analogicus/lelo_gr03_sky130a/svgs/LELO_GR03.png

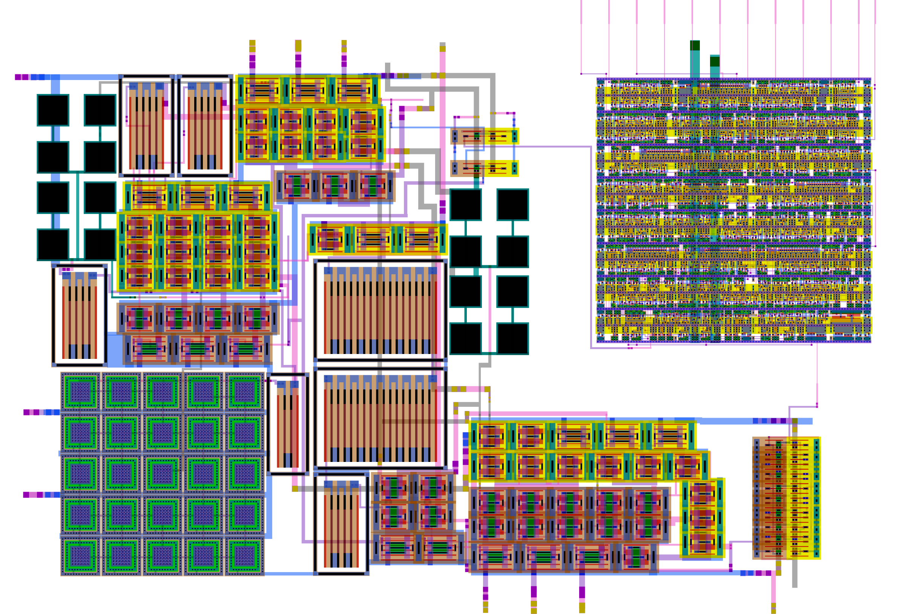
svgs/LELO_GR03.png
