analogicus/lelo_gr03_sky130a/sim/OSCILLATOR_TB/output_tran/sim_params.tex

% Auto-generated by sim/OSCILLATOR_TB/tran.py — do not edit by hand.
% Worst-case 1-pt / 2-pt cal residual in 0–70 °C, per spec.
\providecommand{\valKerrone}{10.7}
\providecommand{\valKerrtwo}{4.0}
