analogicus/lelo_gr03_sky130a/sim/BANDGAP_CIRCUIT_TB/output_tran/sim_params.tex

% Auto-generated by sim/BANDGAP_CIRCUIT_TB/tran.py — do not edit by hand.
% Post-layout PVT corners (N=9) at T=30 degC.
\providecommand{\valPtatSpread}{26}
