analogicus/lelo_gr03_sky130a/svgs/physical_design.pdf

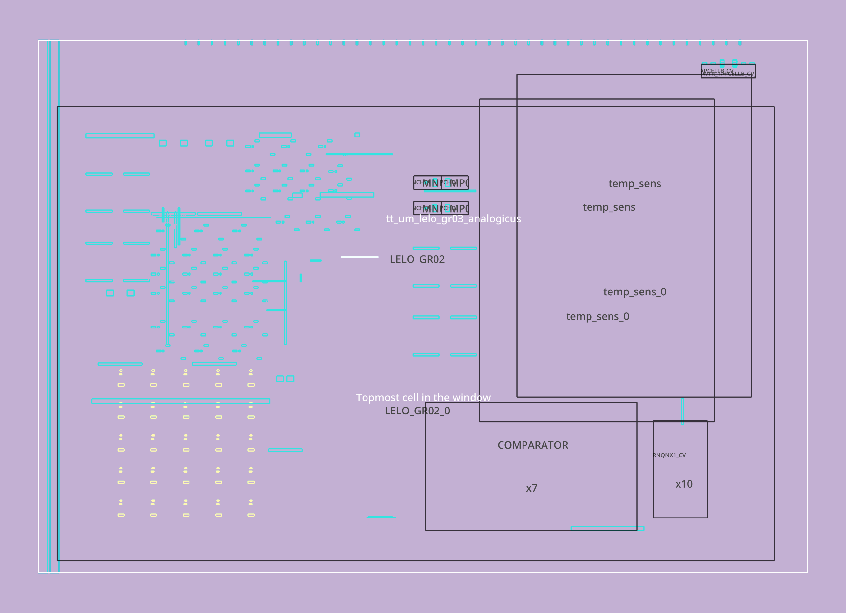
[picture p2: page 1]
