analogicus/lelo_gr03_sky130a/design/simulation/BANDGAP_CIRCUIT_LG_TB.spice

** sch_path: /home/halst/pro/aicex/ip/lelo_gr03_sky130a/design/BANDGAP_CIRCUIT_LG_TB.sch
**.subckt BANDGAP_CIRCUIT_LG_TB I_PTAT
*.opin I_PTAT
V1 VDD_1V8 0 1.8
C1 VDD_1V8 LPI 1f m=1
V2 IN 0 0.8
C2 LPO 0 200f m=1
XQ2<63> 0 0 VD2 sky130_fd_pr__pnp_05v5_W3p40L3p40 m=1 mult=1
XQ2<62> 0 0 VD2 sky130_fd_pr__pnp_05v5_W3p40L3p40 m=1 mult=1
XQ2<61> 0 0 VD2 sky130_fd_pr__pnp_05v5_W3p40L3p40 m=1 mult=1
XQ2<60> 0 0 VD2 sky130_fd_pr__pnp_05v5_W3p40L3p40 m=1 mult=1
XQ2<59> 0 0 VD2 sky130_fd_pr__pnp_05v5_W3p40L3p40 m=1 mult=1
XQ2<58> 0 0 VD2 sky130_fd_pr__pnp_05v5_W3p40L3p40 m=1 mult=1
XQ2<57> 0 0 VD2 sky130_fd_pr__pnp_05v5_W3p40L3p40 m=1 mult=1
XQ2<56> 0 0 VD2 sky130_fd_pr__pnp_05v5_W3p40L3p40 m=1 mult=1
XQ2<55> 0 0 VD2 sky130_fd_pr__pnp_05v5_W3p40L3p40 m=1 mult=1
XQ2<54> 0 0 VD2 sky130_fd_pr__pnp_05v5_W3p40L3p40 m=1 mult=1
XQ2<53> 0 0 VD2 sky130_fd_pr__pnp_05v5_W3p40L3p40 m=1 mult=1
XQ2<52> 0 0 VD2 sky130_fd_pr__pnp_05v5_W3p40L3p40 m=1 mult=1
XQ2<51> 0 0 VD2 sky130_fd_pr__pnp_05v5_W3p40L3p40 m=1 mult=1
XQ2<50> 0 0 VD2 sky130_fd_pr__pnp_05v5_W3p40L3p40 m=1 mult=1
XQ2<49> 0 0 VD2 sky130_fd_pr__pnp_05v5_W3p40L3p40 m=1 mult=1
XQ2<48> 0 0 VD2 sky130_fd_pr__pnp_05v5_W3p40L3p40 m=1 mult=1
XQ2<47> 0 0 VD2 sky130_fd_pr__pnp_05v5_W3p40L3p40 m=1 mult=1
XQ2<46> 0 0 VD2 sky130_fd_pr__pnp_05v5_W3p40L3p40 m=1 mult=1
XQ2<45> 0 0 VD2 sky130_fd_pr__pnp_05v5_W3p40L3p40 m=1 mult=1
XQ2<44> 0 0 VD2 sky130_fd_pr__pnp_05v5_W3p40L3p40 m=1 mult=1
XQ2<43> 0 0 VD2 sky130_fd_pr__pnp_05v5_W3p40L3p40 m=1 mult=1
XQ2<42> 0 0 VD2 sky130_fd_pr__pnp_05v5_W3p40L3p40 m=1 mult=1
XQ2<41> 0 0 VD2 sky130_fd_pr__pnp_05v5_W3p40L3p40 m=1 mult=1
XQ2<40> 0 0 VD2 sky130_fd_pr__pnp_05v5_W3p40L3p40 m=1 mult=1
XQ2<39> 0 0 VD2 sky130_fd_pr__pnp_05v5_W3p40L3p40 m=1 mult=1
XQ2<38> 0 0 VD2 sky130_fd_pr__pnp_05v5_W3p40L3p40 m=1 mult=1
XQ2<37> 0 0 VD2 sky130_fd_pr__pnp_05v5_W3p40L3p40 m=1 mult=1
XQ2<36> 0 0 VD2 sky130_fd_pr__pnp_05v5_W3p40L3p40 m=1 mult=1
XQ2<35> 0 0 VD2 sky130_fd_pr__pnp_05v5_W3p40L3p40 m=1 mult=1
XQ2<34> 0 0 VD2 sky130_fd_pr__pnp_05v5_W3p40L3p40 m=1 mult=1
XQ2<33> 0 0 VD2 sky130_fd_pr__pnp_05v5_W3p40L3p40 m=1 mult=1
XQ2<32> 0 0 VD2 sky130_fd_pr__pnp_05v5_W3p40L3p40 m=1 mult=1
XQ2<31> 0 0 VD2 sky130_fd_pr__pnp_05v5_W3p40L3p40 m=1 mult=1
XQ2<30> 0 0 VD2 sky130_fd_pr__pnp_05v5_W3p40L3p40 m=1 mult=1
XQ2<29> 0 0 VD2 sky130_fd_pr__pnp_05v5_W3p40L3p40 m=1 mult=1
XQ2<28> 0 0 VD2 sky130_fd_pr__pnp_05v5_W3p40L3p40 m=1 mult=1
XQ2<27> 0 0 VD2 sky130_fd_pr__pnp_05v5_W3p40L3p40 m=1 mult=1
XQ2<26> 0 0 VD2 sky130_fd_pr__pnp_05v5_W3p40L3p40 m=1 mult=1
XQ2<25> 0 0 VD2 sky130_fd_pr__pnp_05v5_W3p40L3p40 m=1 mult=1
XQ2<24> 0 0 VD2 sky130_fd_pr__pnp_05v5_W3p40L3p40 m=1 mult=1
XQ2<23> 0 0 VD2 sky130_fd_pr__pnp_05v5_W3p40L3p40 m=1 mult=1
XQ2<22> 0 0 VD2 sky130_fd_pr__pnp_05v5_W3p40L3p40 m=1 mult=1
XQ2<21> 0 0 VD2 sky130_fd_pr__pnp_05v5_W3p40L3p40 m=1 mult=1
XQ2<20> 0 0 VD2 sky130_fd_pr__pnp_05v5_W3p40L3p40 m=1 mult=1
XQ2<19> 0 0 VD2 sky130_fd_pr__pnp_05v5_W3p40L3p40 m=1 mult=1
XQ2<18> 0 0 VD2 sky130_fd_pr__pnp_05v5_W3p40L3p40 m=1 mult=1
XQ2<17> 0 0 VD2 sky130_fd_pr__pnp_05v5_W3p40L3p40 m=1 mult=1
XQ2<16> 0 0 VD2 sky130_fd_pr__pnp_05v5_W3p40L3p40 m=1 mult=1
XQ2<15> 0 0 VD2 sky130_fd_pr__pnp_05v5_W3p40L3p40 m=1 mult=1
XQ2<14> 0 0 VD2 sky130_fd_pr__pnp_05v5_W3p40L3p40 m=1 mult=1
XQ2<13> 0 0 VD2 sky130_fd_pr__pnp_05v5_W3p40L3p40 m=1 mult=1
XQ2<12> 0 0 VD2 sky130_fd_pr__pnp_05v5_W3p40L3p40 m=1 mult=1
XQ2<11> 0 0 VD2 sky130_fd_pr__pnp_05v5_W3p40L3p40 m=1 mult=1
XQ2<10> 0 0 VD2 sky130_fd_pr__pnp_05v5_W3p40L3p40 m=1 mult=1
XQ2<9> 0 0 VD2 sky130_fd_pr__pnp_05v5_W3p40L3p40 m=1 mult=1
XQ2<8> 0 0 VD2 sky130_fd_pr__pnp_05v5_W3p40L3p40 m=1 mult=1
XQ2<7> 0 0 VD2 sky130_fd_pr__pnp_05v5_W3p40L3p40 m=1 mult=1
XQ2<6> 0 0 VD2 sky130_fd_pr__pnp_05v5_W3p40L3p40 m=1 mult=1
XQ2<5> 0 0 VD2 sky130_fd_pr__pnp_05v5_W3p40L3p40 m=1 mult=1
XQ2<4> 0 0 VD2 sky130_fd_pr__pnp_05v5_W3p40L3p40 m=1 mult=1
XQ2<3> 0 0 VD2 sky130_fd_pr__pnp_05v5_W3p40L3p40 m=1 mult=1
XQ2<2> 0 0 VD2 sky130_fd_pr__pnp_05v5_W3p40L3p40 m=1 mult=1
XQ2<1> 0 0 VD2 sky130_fd_pr__pnp_05v5_W3p40L3p40 m=1 mult=1
XQ2<0> 0 0 VD2 sky130_fd_pr__pnp_05v5_W3p40L3p40 m=1 mult=1
XQ2 0 0 net1 sky130_fd_pr__pnp_05v5_W3p40L3p40 m=1 mult=1
x16 VSTART LPI net5 0 JNWATR_NCH_4C5F0
x18 LPI VSTART SUPPLY VDD_1V8 JNWATR_PCH_4C5F0
x9 VSTART VSTART SUPPLY VDD_1V8 JNWATR_PCH_4C5F0
x10 net5 net5 0 0 JNWATR_NCH_4C5F0
x15 LPI LPI 0 0 JNWATR_NCH_4C5F0
x14 SUPPLY LPI JNWTR_CAPX4
x21 VDD_1V8 DV LPO net1 0 0 VDD_1V8 VB_P BANDGAP_OTA_PMOS
x17 net3 LPI SUPPLY VDD_1V8 JNWATR_PCH_2C5F0
x19 net2 LPI SUPPLY VDD_1V8 JNWATR_PCH_2C5F0
x20 net4 LPI SUPPLY VDD_1V8 JNWATR_PCH_2C5F0
x3<2> SUPPLY 0 VDD_1V8 VDD_1V8 JNWATR_PCH_8C1F2
x3<1> SUPPLY 0 VDD_1V8 VDD_1V8 JNWATR_PCH_8C1F2
x3<0> SUPPLY 0 VDD_1V8 VDD_1V8 JNWATR_PCH_8C1F2
x22 V_CTAT LPI net3 VDD_1V8 JNWATR_PCH_2C5F0
x23 net6 LPI net2 VDD_1V8 JNWATR_PCH_2C5F0
x24 I_PTAT LPI net4 VDD_1V8 JNWATR_PCH_2C5F0
x25 VD2 DV 0 JNWTR_RPPO2
x26 V_CTAT DV 0 JNWTR_RPPO4
x27 net1 net6 0 JNWTR_RPPO4
x1 VDD_1V8 VDD_1V8 0 0 VB_P net7 BIAS_CIRCUIT
C3 net7 0 1f m=1
**** begin user architecture code



.lib ../../../tech/ngspice/corners.spi Ktt
.lib ../../../tech/ngspice/temperature.spi Tt
.lib ../../../tech/ngspice/supply.spi Vt
.include ../../../../cpdk/ngspice/tian_subckt.lib
X999 LPI LPO loopgainprobe

.control
optran 0 0 0 10n 20u 0
save alli
save allv
save @m.*[gm]
op
remzerovec
write TB_LELOTEMP_BIAS_IBP_LSTB_OP.raw
unsave all

save allv
save i(v1) i(v2)
* Set voltage AC to 1
ac dec 50 100 1G
* Set Current to 1
alter i.X999.Ii acmag=1
alter v.X999.Vi acmag=0
ac dec 50 100 1G
let lg_mag = db(tian_loop())
let lg_phase = 180*cph(-tian_loop())/pi
remzerovec
write TB_LELOTEMP_BIAS_IBP_LSTB.raw

meas ac gm_db find lg_mag when lg_phase=0
meas ac pm_deg find lg_phase when lg_mag=0
meas ac f3db when lg_phase=135
meas ac ug when lg_mag=0
meas ac lf_gain find lg_mag at=1k
remzerovec
write TB_LELOTEMP_BIAS_IBP_LSTB_meas.raw
exit
.endc
.end



**** end user architecture code
**.ends

* expanding   symbol:  JNW_ATR_SKY130A/JNWATR_NCH_4C5F0.sym # of pins=4
** sym_path: /home/halst/pro/aicex/ip/lelo_gr03_sky130a/design/JNW_ATR_SKY130A/JNWATR_NCH_4C5F0.sym
** sch_path: /home/halst/pro/aicex/ip/lelo_gr03_sky130a/design/JNW_ATR_SKY130A/JNWATR_NCH_4C5F0.sch
.subckt JNWATR_NCH_4C5F0 D G S B
*.iopin D
*.iopin G
*.iopin S
*.iopin B
XM1 D G S B sky130_fd_pr__nfet_01v8 L=0.94 W=3.2 nf=2 ad='int((nf+1)/2) * W/nf * 0.29' as='int((nf+2)/2) * W/nf * 0.29' pd='2*int((nf+1)/2) * (W/nf + 0.29)'
+ ps='2*int((nf+2)/2) * (W/nf + 0.29)' nrd='0.29 / W' nrs='0.29 / W' sa=0 sb=0 sd=0 mult=1 m=1
.ends


* expanding   symbol:  JNW_ATR_SKY130A/JNWATR_PCH_4C5F0.sym # of pins=4
** sym_path: /home/halst/pro/aicex/ip/lelo_gr03_sky130a/design/JNW_ATR_SKY130A/JNWATR_PCH_4C5F0.sym
** sch_path: /home/halst/pro/aicex/ip/lelo_gr03_sky130a/design/JNW_ATR_SKY130A/JNWATR_PCH_4C5F0.sch
.subckt JNWATR_PCH_4C5F0 D G S B
*.iopin D
*.iopin G
*.iopin S
*.iopin B
XM1 D G S B sky130_fd_pr__pfet_01v8 L=0.94 W=3.2 nf=2 ad='int((nf+1)/2) * W/nf * 0.29' as='int((nf+2)/2) * W/nf * 0.29' pd='2*int((nf+1)/2) * (W/nf + 0.29)'
+ ps='2*int((nf+2)/2) * (W/nf + 0.29)' nrd='0.29 / W' nrs='0.29 / W' sa=0 sb=0 sd=0 mult=1 m=1
.ends


* expanding   symbol:  JNW_TR_SKY130A/JNWTR_CAPX4.sym # of pins=2
** sym_path: /home/halst/pro/aicex/ip/lelo_gr03_sky130a/design/JNW_TR_SKY130A/JNWTR_CAPX4.sym
** sch_path: /home/halst/pro/aicex/ip/lelo_gr03_sky130a/design/JNW_TR_SKY130A/JNWTR_CAPX4.sch
.subckt JNWTR_CAPX4 A B
*.iopin A
*.iopin B
XXA1 A B JNWTR_CAPX1
XXA2 A B JNWTR_CAPX1
XXB1 A B JNWTR_CAPX1
XXB2 A B JNWTR_CAPX1
.ends


* expanding   symbol:  LELO_GR03_SKY130A/BANDGAP_OTA_PMOS.sym # of pins=8
** sym_path: /home/halst/pro/aicex/ip/lelo_gr03_sky130a/design/LELO_GR03_SKY130A/BANDGAP_OTA_PMOS.sym
** sch_path: /home/halst/pro/aicex/ip/lelo_gr03_sky130a/design/LELO_GR03_SKY130A/BANDGAP_OTA_PMOS.sch
.subckt BANDGAP_OTA_PMOS VDD IN+ OUT IN- VSS PWRUP_N_1V8 PWRUP_1V8 VB_P
*.ipin IN-
*.opin OUT
*.ipin VSS
*.ipin PWRUP_N_1V8
*.ipin VDD
*.ipin PWRUP_1V8
*.ipin VB_P
*.ipin IN+
x6 OUT net6 net1 VSS JNWATR_NCH_4C5F0
x11<2> OUT net2 JNWTR_CAPX4
x11<1> OUT net2 JNWTR_CAPX4
x11<0> OUT net2 JNWTR_CAPX4
x3<1> net4<1> VB_P net3 VDD JNWATR_PCH_4C5F0
x3<0> net4<0> VB_P net3 VDD JNWATR_PCH_4C5F0
x2 OUT VB_P net3 VDD JNWATR_PCH_4C5F0
x3 net6 net5 net1 VSS JNWATR_NCH_4C5F0
x4 net5 net5 net1 VSS JNWATR_NCH_4C5F0
x2<2> net5 IN- net4<1> VDD LELOATR_LVT_PCH_4C5F0
x2<1> net5 IN- net4<0> VDD LELOATR_LVT_PCH_4C5F0
x2<0> net5 IN- net4<1> VDD LELOATR_LVT_PCH_4C5F0
x5<2> net6 IN+ net4<1> VDD LELOATR_LVT_PCH_4C5F0
x5<1> net6 IN+ net4<0> VDD LELOATR_LVT_PCH_4C5F0
x5<0> net6 IN+ net4<1> VDD LELOATR_LVT_PCH_4C5F0
x1 net2 net6 VSS JNWTR_RPPO4
x1<2> net3 PWRUP_N_1V8 VDD VDD JNWATR_PCH_8C1F2
x1<1> net3 PWRUP_N_1V8 VDD VDD JNWATR_PCH_8C1F2
x1<0> net3 PWRUP_N_1V8 VDD VDD JNWATR_PCH_8C1F2
x4<2> net1 PWRUP_1V8 VSS VSS JNWATR_NCH_8C1F2
x4<1> net1 PWRUP_1V8 VSS VSS JNWATR_NCH_8C1F2
x4<0> net1 PWRUP_1V8 VSS VSS JNWATR_NCH_8C1F2
.ends


* expanding   symbol:  JNW_ATR_SKY130A/JNWATR_PCH_2C5F0.sym # of pins=4
** sym_path: /home/halst/pro/aicex/ip/lelo_gr03_sky130a/design/JNW_ATR_SKY130A/JNWATR_PCH_2C5F0.sym
** sch_path: /home/halst/pro/aicex/ip/lelo_gr03_sky130a/design/JNW_ATR_SKY130A/JNWATR_PCH_2C5F0.sch
.subckt JNWATR_PCH_2C5F0 D G S B
*.iopin D
*.iopin G
*.iopin S
*.iopin B
XM1 D G S B sky130_fd_pr__pfet_01v8 L=0.94 W=1.92 nf=2 ad='int((nf+1)/2) * W/nf * 0.29' as='int((nf+2)/2) * W/nf * 0.29' pd='2*int((nf+1)/2) * (W/nf + 0.29)'
+ ps='2*int((nf+2)/2) * (W/nf + 0.29)' nrd='0.29 / W' nrs='0.29 / W' sa=0 sb=0 sd=0 mult=1 m=1
.ends


* expanding   symbol:  JNW_ATR_SKY130A/JNWATR_PCH_8C1F2.sym # of pins=4
** sym_path: /home/halst/pro/aicex/ip/lelo_gr03_sky130a/design/JNW_ATR_SKY130A/JNWATR_PCH_8C1F2.sym
** sch_path: /home/halst/pro/aicex/ip/lelo_gr03_sky130a/design/JNW_ATR_SKY130A/JNWATR_PCH_8C1F2.sch
.subckt JNWATR_PCH_8C1F2 D G S B
*.iopin D
*.iopin G
*.iopin S
*.iopin B
XM1 D G S B sky130_fd_pr__pfet_01v8 L=0.22 W=5.76 nf=2 ad='int((nf+1)/2) * W/nf * 0.29' as='int((nf+2)/2) * W/nf * 0.29' pd='2*int((nf+1)/2) * (W/nf + 0.29)'
+ ps='2*int((nf+2)/2) * (W/nf + 0.29)' nrd='0.29 / W' nrs='0.29 / W' sa=0 sb=0 sd=0 mult=1 m=1
.ends


* expanding   symbol:  JNW_TR_SKY130A/JNWTR_RPPO2.sym # of pins=3
** sym_path: /home/halst/pro/aicex/ip/lelo_gr03_sky130a/design/JNW_TR_SKY130A/JNWTR_RPPO2.sym
** sch_path: /home/halst/pro/aicex/ip/lelo_gr03_sky130a/design/JNW_TR_SKY130A/JNWTR_RPPO2.sch
.subckt JNWTR_RPPO2 N P B
*.iopin P
*.iopin N
*.iopin B
XXA1 N P B JNWTR_RES2
.ends


* expanding   symbol:  JNW_TR_SKY130A/JNWTR_RPPO4.sym # of pins=3
** sym_path: /home/halst/pro/aicex/ip/lelo_gr03_sky130a/design/JNW_TR_SKY130A/JNWTR_RPPO4.sym
** sch_path: /home/halst/pro/aicex/ip/lelo_gr03_sky130a/design/JNW_TR_SKY130A/JNWTR_RPPO4.sch
.subckt JNWTR_RPPO4 N P B
*.iopin P
*.iopin N
*.iopin B
XXA1 N P B JNWTR_RES4
.ends


* expanding   symbol:  LELO_GR03_SKY130A/BIAS_CIRCUIT.sym # of pins=6
** sym_path: /home/halst/pro/aicex/ip/lelo_gr03_sky130a/design/LELO_GR03_SKY130A/BIAS_CIRCUIT.sym
** sch_path: /home/halst/pro/aicex/ip/lelo_gr03_sky130a/design/LELO_GR03_SKY130A/BIAS_CIRCUIT.sch
.subckt BIAS_CIRCUIT VDD_1V8 PWRUP_1V8 PWRUP_N_1V8 VSS VB_P VB_N
*.ipin VDD_1V8
*.ipin VSS
*.ipin PWRUP_1V8
*.ipin PWRUP_N_1V8
*.opin VB_P
*.opin VB_N
x3 VB_N VB_N net2 VSS JNWATR_NCH_4C5F0
x11 net5 net1 VSS JNWTR_RPPO16
x12 net1 PWRUP_N_1V8 VDD_1V8 VDD_1V8 JNWATR_PCH_8C1F2
x13 net2 PWRUP_1V8 VSS VSS JNWATR_NCH_8C1F2
x15 VB_P VB_N net3 VSS JNWATR_NCH_4C5F0
x16 net3 PWRUP_1V8 VSS VSS JNWATR_NCH_8C1F2
x17 VB_P VB_P net4 VDD_1V8 JNWATR_PCH_4C5F0
x18 net4 PWRUP_N_1V8 VDD_1V8 VDD_1V8 JNWATR_PCH_8C1F2
x19 net5 net6 VSS JNWTR_RPPO16
x14 VB_N net6 VSS JNWTR_RPPO4
.ends


* expanding   symbol:  JNW_TR_SKY130A/JNWTR_CAPX1.sym # of pins=2
** sym_path: /home/halst/pro/aicex/ip/lelo_gr03_sky130a/design/JNW_TR_SKY130A/JNWTR_CAPX1.sym
** sch_path: /home/halst/pro/aicex/ip/lelo_gr03_sky130a/design/JNW_TR_SKY130A/JNWTR_CAPX1.sch
.subckt JNWTR_CAPX1 A B
*.iopin A
*.iopin B
XC1 B A sky130_fd_pr__cap_mim_m3_1 W=5 L=5 MF=1 m=1
.ends


* expanding   symbol:  LELO_ATR_SKY130A/LELOATR_LVT_PCH_4C5F0.sym # of pins=4
** sym_path: /home/halst/pro/aicex/ip/lelo_gr03_sky130a/design/LELO_ATR_SKY130A/LELOATR_LVT_PCH_4C5F0.sym
** sch_path: /home/halst/pro/aicex/ip/lelo_gr03_sky130a/design/LELO_ATR_SKY130A/LELOATR_LVT_PCH_4C5F0.sch
.subckt LELOATR_LVT_PCH_4C5F0 D G S B
*.iopin D
*.iopin G
*.iopin S
*.iopin B
XM1 D G S B sky130_fd_pr__pfet_01v8_lvt L=0.94 W=3.2 nf=2 ad='int((nf+1)/2) * W/nf * 0.29' as='int((nf+2)/2) * W/nf * 0.29' pd='2*int((nf+1)/2) * (W/nf + 0.29)'
+ ps='2*int((nf+2)/2) * (W/nf + 0.29)' nrd='0.29 / W' nrs='0.29 / W' sa=0 sb=0 sd=0 mult=1 m=1
.ends


* expanding   symbol:  JNW_ATR_SKY130A/JNWATR_NCH_8C1F2.sym # of pins=4
** sym_path: /home/halst/pro/aicex/ip/lelo_gr03_sky130a/design/JNW_ATR_SKY130A/JNWATR_NCH_8C1F2.sym
** sch_path: /home/halst/pro/aicex/ip/lelo_gr03_sky130a/design/JNW_ATR_SKY130A/JNWATR_NCH_8C1F2.sch
.subckt JNWATR_NCH_8C1F2 D G S B
*.iopin D
*.iopin G
*.iopin S
*.iopin B
XM1 D G S B sky130_fd_pr__nfet_01v8 L=0.22 W=5.76 nf=2 ad='int((nf+1)/2) * W/nf * 0.29' as='int((nf+2)/2) * W/nf * 0.29' pd='2*int((nf+1)/2) * (W/nf + 0.29)'
+ ps='2*int((nf+2)/2) * (W/nf + 0.29)' nrd='0.29 / W' nrs='0.29 / W' sa=0 sb=0 sd=0 mult=1 m=1
.ends


* expanding   symbol:  JNW_TR_SKY130A/JNWTR_RES2.sym # of pins=3
** sym_path: /home/halst/pro/aicex/ip/lelo_gr03_sky130a/design/JNW_TR_SKY130A/JNWTR_RES2.sym
** sch_path: /home/halst/pro/aicex/ip/lelo_gr03_sky130a/design/JNW_TR_SKY130A/JNWTR_RES2.sch
.subckt JNWTR_RES2 N P B
*.iopin N
*.iopin P
*.iopin B
XR1_0 INT_0 N B sky130_fd_pr__res_high_po W=0.36 L=7.36 mult=1 m=1
XR1_1 P INT_0 B sky130_fd_pr__res_high_po W=0.36 L=7.36 mult=1 m=1
.ends


* expanding   symbol:  JNW_TR_SKY130A/JNWTR_RES4.sym # of pins=3
** sym_path: /home/halst/pro/aicex/ip/lelo_gr03_sky130a/design/JNW_TR_SKY130A/JNWTR_RES4.sym
** sch_path: /home/halst/pro/aicex/ip/lelo_gr03_sky130a/design/JNW_TR_SKY130A/JNWTR_RES4.sch
.subckt JNWTR_RES4 N P B
*.iopin N
*.iopin P
*.iopin B
XR1_0 INT_0 N B sky130_fd_pr__res_high_po W=0.36 L=7.36 mult=1 m=1
XR1_1 INT_1 INT_0 B sky130_fd_pr__res_high_po W=0.36 L=7.36 mult=1 m=1
XR1_2 INT_2 INT_1 B sky130_fd_pr__res_high_po W=0.36 L=7.36 mult=1 m=1
XR1_3 P INT_2 B sky130_fd_pr__res_high_po W=0.36 L=7.36 mult=1 m=1
.ends


* expanding   symbol:  JNW_TR_SKY130A/JNWTR_RPPO16.sym # of pins=3
** sym_path: /home/halst/pro/aicex/ip/lelo_gr03_sky130a/design/JNW_TR_SKY130A/JNWTR_RPPO16.sym
** sch_path: /home/halst/pro/aicex/ip/lelo_gr03_sky130a/design/JNW_TR_SKY130A/JNWTR_RPPO16.sch
.subckt JNWTR_RPPO16 N P B
*.iopin P
*.iopin N
*.iopin B
XXA1 N P B JNWTR_RES16
.ends


* expanding   symbol:  JNW_TR_SKY130A/JNWTR_RES16.sym # of pins=3
** sym_path: /home/halst/pro/aicex/ip/lelo_gr03_sky130a/design/JNW_TR_SKY130A/JNWTR_RES16.sym
** sch_path: /home/halst/pro/aicex/ip/lelo_gr03_sky130a/design/JNW_TR_SKY130A/JNWTR_RES16.sch
.subckt JNWTR_RES16 N P B
*.iopin N
*.iopin P
*.iopin B
XR1_0 INT_0 N B sky130_fd_pr__res_high_po W=0.36 L=7.36 mult=1 m=1
XR1_1 INT_1 INT_0 B sky130_fd_pr__res_high_po W=0.36 L=7.36 mult=1 m=1
XR1_2 INT_2 INT_1 B sky130_fd_pr__res_high_po W=0.36 L=7.36 mult=1 m=1
XR1_3 INT_3 INT_2 B sky130_fd_pr__res_high_po W=0.36 L=7.36 mult=1 m=1
XR1_4 INT_4 INT_3 B sky130_fd_pr__res_high_po W=0.36 L=7.36 mult=1 m=1
XR1_5 INT_5 INT_4 B sky130_fd_pr__res_high_po W=0.36 L=7.36 mult=1 m=1
XR1_6 INT_6 INT_5 B sky130_fd_pr__res_high_po W=0.36 L=7.36 mult=1 m=1
XR1_7 INT_7 INT_6 B sky130_fd_pr__res_high_po W=0.36 L=7.36 mult=1 m=1
XR1_8 INT_8 INT_7 B sky130_fd_pr__res_high_po W=0.36 L=7.36 mult=1 m=1
XR1_9 INT_9 INT_8 B sky130_fd_pr__res_high_po W=0.36 L=7.36 mult=1 m=1
XR1_10 INT_10 INT_9 B sky130_fd_pr__res_high_po W=0.36 L=7.36 mult=1 m=1
XR1_11 INT_11 INT_10 B sky130_fd_pr__res_high_po W=0.36 L=7.36 mult=1 m=1
XR1_12 INT_12 INT_11 B sky130_fd_pr__res_high_po W=0.36 L=7.36 mult=1 m=1
XR1_13 INT_13 INT_12 B sky130_fd_pr__res_high_po W=0.36 L=7.36 mult=1 m=1
XR1_14 INT_14 INT_13 B sky130_fd_pr__res_high_po W=0.36 L=7.36 mult=1 m=1
XR1_15 P INT_14 B sky130_fd_pr__res_high_po W=0.36 L=7.36 mult=1 m=1
.ends

.end
