analogicus/lelo_gr03_sky130a/design/LELO_GR03_SKY130A/simulation/BANDGAP_OTA_TB.spice

** sch_path: /home/halst/pro/aicex/ip/lelo_gr03_sky130a/design/LELO_GR03_SKY130A/BANDGAP_OTA_TB.sch
**.subckt BANDGAP_OTA_TB
CL OUT_NMOS 0 300f m=1
VIN IN+ 0 sin(0.55 3m 1k)
V_REF IN- 0 sin(0.55 -3m 1k)
VDD VDD 0 1.8
x1 VDD IN+ OUT_NMOS IN- 0 0 VDD V_IBN BANDGAP_OTA
x2 VDD IN+ OUT_PMOS IN- 0 0 VDD V_IBP BANDGAP_OTA_PMOS
CL1 OUT_PMOS 0 300f m=1
x3 V_IBN V_IBN net2 0 JNWATR_NCH_4C5F0
x11 net3 net1 0 JNWTR_RPPO16
x12 net1 0 VDD VDD JNWATR_PCH_8C1F2
x13 net2 VDD 0 0 JNWATR_NCH_8C1F2
x14 V_IBN net3 0 JNWTR_RPPO2
x4 net4 VDD 0 0 JNWATR_NCH_8C1F2
x5 V_IBP V_IBN net4 0 JNWATR_NCH_4C5F0
x6 net5 0 VDD VDD JNWATR_PCH_8C1F2
x7 V_IBP V_IBP net5 VDD JNWATR_PCH_4C5F0
**** begin user architecture code


.param mc_mm_switch=0
.param mc_pr_switch=0

.lib ../../../tech/ngspice/temperature.spi Tl
.lib ../../../tech/ngspice/corners.spi Kss
.lib ../../../tech/ngspice/supply.spi Vl
.include ../../../../cpdk/ngspice/ideal_circuits.spi
*.option savecurrents
.option gmin=1e-12
*.option SEED=1
.save all
.control

optran 0 0 0 10n 1u 0
*dc VIN 0 1.8 1m
tran 0.5u 6m
*op
*ac dec 20 1 1G

write BANDGAP_OTA_TB.raw

exit
.endc


**** end user architecture code
**.ends

* expanding   symbol:  LELO_GR03_SKY130A/BANDGAP_OTA.sym # of pins=8
** sym_path: /home/halst/pro/aicex/ip/lelo_gr03_sky130a/design/LELO_GR03_SKY130A/BANDGAP_OTA.sym
** sch_path: /home/halst/pro/aicex/ip/lelo_gr03_sky130a/design/LELO_GR03_SKY130A/BANDGAP_OTA.sch
.subckt BANDGAP_OTA VDD IN+ OUT IN- VSS PWRUP_N_1V8 PWRUP_1V8 V_IB
*.ipin IN-
*.opin OUT
*.ipin IN+
*.ipin VSS
*.ipin PWRUP_N_1V8
*.ipin VDD
*.ipin PWRUP_1V8
*.ipin V_IB
x18<4> VB_P IN- VTAIL VSS LELOATR_LVT_NCH_4C5F0
x18<3> VB_P IN- VTAIL VSS LELOATR_LVT_NCH_4C5F0
x18<2> VB_P IN- VTAIL VSS LELOATR_LVT_NCH_4C5F0
x18<1> VB_P IN- VTAIL VSS LELOATR_LVT_NCH_4C5F0
x18<0> VB_P IN- VTAIL VSS LELOATR_LVT_NCH_4C5F0
x19<4> V2 IN+ VTAIL VSS LELOATR_LVT_NCH_4C5F0
x19<3> V2 IN+ VTAIL VSS LELOATR_LVT_NCH_4C5F0
x19<2> V2 IN+ VTAIL VSS LELOATR_LVT_NCH_4C5F0
x19<1> V2 IN+ VTAIL VSS LELOATR_LVT_NCH_4C5F0
x19<0> V2 IN+ VTAIL VSS LELOATR_LVT_NCH_4C5F0
x2<1> VTAIL V_IB net2 VSS JNWATR_NCH_4C5F0
x2<0> VTAIL V_IB net2 VSS JNWATR_NCH_4C5F0
x20 V2 VB_P net1 VDD JNWATR_PCH_4C5F0
x21 VB_P VB_P net1 VDD JNWATR_PCH_4C5F0
x10 OUT V2 net1 VDD JNWATR_PCH_4C5F0
x6 OUT V_IB net2 VSS JNWATR_NCH_4C5F0
x9 net3 V2 VSS JNWTR_RPPO2
x11 OUT net3 JNWTR_CAPX4
x1<2> net2 PWRUP_1V8 VSS VSS JNWATR_NCH_8C1F2
x1<1> net2 PWRUP_1V8 VSS VSS JNWATR_NCH_8C1F2
x1<0> net2 PWRUP_1V8 VSS VSS JNWATR_NCH_8C1F2
x4<2> net1 PWRUP_N_1V8 VDD VDD JNWATR_PCH_8C1F2
x4<1> net1 PWRUP_N_1V8 VDD VDD JNWATR_PCH_8C1F2
x4<0> net1 PWRUP_N_1V8 VDD VDD JNWATR_PCH_8C1F2
.ends


* expanding   symbol:  LELO_GR03_SKY130A/BANDGAP_OTA_PMOS.sym # of pins=8
** sym_path: /home/halst/pro/aicex/ip/lelo_gr03_sky130a/design/LELO_GR03_SKY130A/BANDGAP_OTA_PMOS.sym
** sch_path: /home/halst/pro/aicex/ip/lelo_gr03_sky130a/design/LELO_GR03_SKY130A/BANDGAP_OTA_PMOS.sch
.subckt BANDGAP_OTA_PMOS VDD IN+ OUT IN- VSS PWRUP_N_1V8 PWRUP_1V8 V_IBP
*.ipin IN-
*.opin OUT
*.ipin VSS
*.ipin PWRUP_N_1V8
*.ipin VDD
*.ipin PWRUP_1V8
*.ipin V_IBP
*.ipin IN+
x6 OUT net6 net1 VSS JNWATR_NCH_4C5F0
x9 net2 net6 VSS JNWTR_RPPO2
x11 OUT net2 JNWTR_CAPX4
x1<2> net1 PWRUP_1V8 VSS VSS JNWATR_NCH_8C1F2
x1<1> net1 PWRUP_1V8 VSS VSS JNWATR_NCH_8C1F2
x1<0> net1 PWRUP_1V8 VSS VSS JNWATR_NCH_8C1F2
x4<2> net3 PWRUP_N_1V8 VDD VDD JNWATR_PCH_8C1F2
x4<1> net3 PWRUP_N_1V8 VDD VDD JNWATR_PCH_8C1F2
x4<0> net3 PWRUP_N_1V8 VDD VDD JNWATR_PCH_8C1F2
x3<1> net4<1> V_IBP net3 VDD JNWATR_PCH_4C5F0
x3<0> net4<0> V_IBP net3 VDD JNWATR_PCH_4C5F0
x5 OUT V_IBP net3 VDD JNWATR_PCH_4C5F0
x3 net6 net5 net1 VSS JNWATR_NCH_4C5F0
x4 net5 net5 net1 VSS JNWATR_NCH_4C5F0
x2<2> net5 IN- net4<1> VDD LELOATR_LVT_PCH_4C5F0
x2<1> net5 IN- net4<0> VDD LELOATR_LVT_PCH_4C5F0
x2<0> net5 IN- net4<1> VDD LELOATR_LVT_PCH_4C5F0
x5<2> net6 IN+ net4<1> VDD LELOATR_LVT_PCH_4C5F0
x5<1> net6 IN+ net4<0> VDD LELOATR_LVT_PCH_4C5F0
x5<0> net6 IN+ net4<1> VDD LELOATR_LVT_PCH_4C5F0
.ends


* expanding   symbol:  JNW_ATR_SKY130A/JNWATR_NCH_4C5F0.sym # of pins=4
** sym_path: /home/halst/pro/aicex/ip/lelo_gr03_sky130a/design/JNW_ATR_SKY130A/JNWATR_NCH_4C5F0.sym
** sch_path: /home/halst/pro/aicex/ip/lelo_gr03_sky130a/design/JNW_ATR_SKY130A/JNWATR_NCH_4C5F0.sch
.subckt JNWATR_NCH_4C5F0 D G S B
*.iopin D
*.iopin G
*.iopin S
*.iopin B
XM1 D G S B sky130_fd_pr__nfet_01v8 L=0.94 W=3.2 nf=2 ad='int((nf+1)/2) * W/nf * 0.29' as='int((nf+2)/2) * W/nf * 0.29' pd='2*int((nf+1)/2) * (W/nf + 0.29)'
+ ps='2*int((nf+2)/2) * (W/nf + 0.29)' nrd='0.29 / W' nrs='0.29 / W' sa=0 sb=0 sd=0 mult=1 m=1
.ends


* expanding   symbol:  JNW_TR_SKY130A/JNWTR_RPPO16.sym # of pins=3
** sym_path: /home/halst/pro/aicex/ip/lelo_gr03_sky130a/design/JNW_TR_SKY130A/JNWTR_RPPO16.sym
** sch_path: /home/halst/pro/aicex/ip/lelo_gr03_sky130a/design/JNW_TR_SKY130A/JNWTR_RPPO16.sch
.subckt JNWTR_RPPO16 N P B
*.iopin P
*.iopin N
*.iopin B
XXA1 N P B JNWTR_RES16
.ends


* expanding   symbol:  JNW_ATR_SKY130A/JNWATR_PCH_8C1F2.sym # of pins=4
** sym_path: /home/halst/pro/aicex/ip/lelo_gr03_sky130a/design/JNW_ATR_SKY130A/JNWATR_PCH_8C1F2.sym
** sch_path: /home/halst/pro/aicex/ip/lelo_gr03_sky130a/design/JNW_ATR_SKY130A/JNWATR_PCH_8C1F2.sch
.subckt JNWATR_PCH_8C1F2 D G S B
*.iopin D
*.iopin G
*.iopin S
*.iopin B
XM1 D G S B sky130_fd_pr__pfet_01v8 L=0.22 W=5.76 nf=2 ad='int((nf+1)/2) * W/nf * 0.29' as='int((nf+2)/2) * W/nf * 0.29' pd='2*int((nf+1)/2) * (W/nf + 0.29)'
+ ps='2*int((nf+2)/2) * (W/nf + 0.29)' nrd='0.29 / W' nrs='0.29 / W' sa=0 sb=0 sd=0 mult=1 m=1
.ends


* expanding   symbol:  JNW_ATR_SKY130A/JNWATR_NCH_8C1F2.sym # of pins=4
** sym_path: /home/halst/pro/aicex/ip/lelo_gr03_sky130a/design/JNW_ATR_SKY130A/JNWATR_NCH_8C1F2.sym
** sch_path: /home/halst/pro/aicex/ip/lelo_gr03_sky130a/design/JNW_ATR_SKY130A/JNWATR_NCH_8C1F2.sch
.subckt JNWATR_NCH_8C1F2 D G S B
*.iopin D
*.iopin G
*.iopin S
*.iopin B
XM1 D G S B sky130_fd_pr__nfet_01v8 L=0.22 W=5.76 nf=2 ad='int((nf+1)/2) * W/nf * 0.29' as='int((nf+2)/2) * W/nf * 0.29' pd='2*int((nf+1)/2) * (W/nf + 0.29)'
+ ps='2*int((nf+2)/2) * (W/nf + 0.29)' nrd='0.29 / W' nrs='0.29 / W' sa=0 sb=0 sd=0 mult=1 m=1
.ends


* expanding   symbol:  JNW_TR_SKY130A/JNWTR_RPPO2.sym # of pins=3
** sym_path: /home/halst/pro/aicex/ip/lelo_gr03_sky130a/design/JNW_TR_SKY130A/JNWTR_RPPO2.sym
** sch_path: /home/halst/pro/aicex/ip/lelo_gr03_sky130a/design/JNW_TR_SKY130A/JNWTR_RPPO2.sch
.subckt JNWTR_RPPO2 N P B
*.iopin P
*.iopin N
*.iopin B
XXA1 N P B JNWTR_RES2
.ends


* expanding   symbol:  JNW_ATR_SKY130A/JNWATR_PCH_4C5F0.sym # of pins=4
** sym_path: /home/halst/pro/aicex/ip/lelo_gr03_sky130a/design/JNW_ATR_SKY130A/JNWATR_PCH_4C5F0.sym
** sch_path: /home/halst/pro/aicex/ip/lelo_gr03_sky130a/design/JNW_ATR_SKY130A/JNWATR_PCH_4C5F0.sch
.subckt JNWATR_PCH_4C5F0 D G S B
*.iopin D
*.iopin G
*.iopin S
*.iopin B
XM1 D G S B sky130_fd_pr__pfet_01v8 L=0.94 W=3.2 nf=2 ad='int((nf+1)/2) * W/nf * 0.29' as='int((nf+2)/2) * W/nf * 0.29' pd='2*int((nf+1)/2) * (W/nf + 0.29)'
+ ps='2*int((nf+2)/2) * (W/nf + 0.29)' nrd='0.29 / W' nrs='0.29 / W' sa=0 sb=0 sd=0 mult=1 m=1
.ends


* expanding   symbol:  LELO_ATR_SKY130A/LELOATR_LVT_NCH_4C5F0.sym # of pins=4
** sym_path: /home/halst/pro/aicex/ip/lelo_gr03_sky130a/design/LELO_ATR_SKY130A/LELOATR_LVT_NCH_4C5F0.sym
** sch_path: /home/halst/pro/aicex/ip/lelo_gr03_sky130a/design/LELO_ATR_SKY130A/LELOATR_LVT_NCH_4C5F0.sch
.subckt LELOATR_LVT_NCH_4C5F0 D G S B
*.iopin D
*.iopin G
*.iopin S
*.iopin B
XM1 D G S B sky130_fd_pr__nfet_01v8_lvt L=0.94 W=3.2 nf=2 ad='int((nf+1)/2) * W/nf * 0.29' as='int((nf+2)/2) * W/nf * 0.29' pd='2*int((nf+1)/2) * (W/nf + 0.29)'
+ ps='2*int((nf+2)/2) * (W/nf + 0.29)' nrd='0.29 / W' nrs='0.29 / W' sa=0 sb=0 sd=0 mult=1 m=1
.ends


* expanding   symbol:  JNW_TR_SKY130A/JNWTR_CAPX4.sym # of pins=2
** sym_path: /home/halst/pro/aicex/ip/lelo_gr03_sky130a/design/JNW_TR_SKY130A/JNWTR_CAPX4.sym
** sch_path: /home/halst/pro/aicex/ip/lelo_gr03_sky130a/design/JNW_TR_SKY130A/JNWTR_CAPX4.sch
.subckt JNWTR_CAPX4 A B
*.iopin A
*.iopin B
XXA1 A B JNWTR_CAPX1
XXA2 A B JNWTR_CAPX1
XXB1 A B JNWTR_CAPX1
XXB2 A B JNWTR_CAPX1
.ends


* expanding   symbol:  LELO_ATR_SKY130A/LELOATR_LVT_PCH_4C5F0.sym # of pins=4
** sym_path: /home/halst/pro/aicex/ip/lelo_gr03_sky130a/design/LELO_ATR_SKY130A/LELOATR_LVT_PCH_4C5F0.sym
** sch_path: /home/halst/pro/aicex/ip/lelo_gr03_sky130a/design/LELO_ATR_SKY130A/LELOATR_LVT_PCH_4C5F0.sch
.subckt LELOATR_LVT_PCH_4C5F0 D G S B
*.iopin D
*.iopin G
*.iopin S
*.iopin B
XM1 D G S B sky130_fd_pr__pfet_01v8_lvt L=0.94 W=3.2 nf=2 ad='int((nf+1)/2) * W/nf * 0.29' as='int((nf+2)/2) * W/nf * 0.29' pd='2*int((nf+1)/2) * (W/nf + 0.29)'
+ ps='2*int((nf+2)/2) * (W/nf + 0.29)' nrd='0.29 / W' nrs='0.29 / W' sa=0 sb=0 sd=0 mult=1 m=1
.ends


* expanding   symbol:  JNW_TR_SKY130A/JNWTR_RES16.sym # of pins=3
** sym_path: /home/halst/pro/aicex/ip/lelo_gr03_sky130a/design/JNW_TR_SKY130A/JNWTR_RES16.sym
** sch_path: /home/halst/pro/aicex/ip/lelo_gr03_sky130a/design/JNW_TR_SKY130A/JNWTR_RES16.sch
.subckt JNWTR_RES16 N P B
*.iopin N
*.iopin P
*.iopin B
XR1_0 INT_0 N B sky130_fd_pr__res_high_po W=0.36 L=7.36 mult=1 m=1
XR1_1 INT_1 INT_0 B sky130_fd_pr__res_high_po W=0.36 L=7.36 mult=1 m=1
XR1_2 INT_2 INT_1 B sky130_fd_pr__res_high_po W=0.36 L=7.36 mult=1 m=1
XR1_3 INT_3 INT_2 B sky130_fd_pr__res_high_po W=0.36 L=7.36 mult=1 m=1
XR1_4 INT_4 INT_3 B sky130_fd_pr__res_high_po W=0.36 L=7.36 mult=1 m=1
XR1_5 INT_5 INT_4 B sky130_fd_pr__res_high_po W=0.36 L=7.36 mult=1 m=1
XR1_6 INT_6 INT_5 B sky130_fd_pr__res_high_po W=0.36 L=7.36 mult=1 m=1
XR1_7 INT_7 INT_6 B sky130_fd_pr__res_high_po W=0.36 L=7.36 mult=1 m=1
XR1_8 INT_8 INT_7 B sky130_fd_pr__res_high_po W=0.36 L=7.36 mult=1 m=1
XR1_9 INT_9 INT_8 B sky130_fd_pr__res_high_po W=0.36 L=7.36 mult=1 m=1
XR1_10 INT_10 INT_9 B sky130_fd_pr__res_high_po W=0.36 L=7.36 mult=1 m=1
XR1_11 INT_11 INT_10 B sky130_fd_pr__res_high_po W=0.36 L=7.36 mult=1 m=1
XR1_12 INT_12 INT_11 B sky130_fd_pr__res_high_po W=0.36 L=7.36 mult=1 m=1
XR1_13 INT_13 INT_12 B sky130_fd_pr__res_high_po W=0.36 L=7.36 mult=1 m=1
XR1_14 INT_14 INT_13 B sky130_fd_pr__res_high_po W=0.36 L=7.36 mult=1 m=1
XR1_15 P INT_14 B sky130_fd_pr__res_high_po W=0.36 L=7.36 mult=1 m=1
.ends


* expanding   symbol:  JNW_TR_SKY130A/JNWTR_RES2.sym # of pins=3
** sym_path: /home/halst/pro/aicex/ip/lelo_gr03_sky130a/design/JNW_TR_SKY130A/JNWTR_RES2.sym
** sch_path: /home/halst/pro/aicex/ip/lelo_gr03_sky130a/design/JNW_TR_SKY130A/JNWTR_RES2.sch
.subckt JNWTR_RES2 N P B
*.iopin N
*.iopin P
*.iopin B
XR1_0 INT_0 N B sky130_fd_pr__res_high_po W=0.36 L=7.36 mult=1 m=1
XR1_1 P INT_0 B sky130_fd_pr__res_high_po W=0.36 L=7.36 mult=1 m=1
.ends


* expanding   symbol:  JNW_TR_SKY130A/JNWTR_CAPX1.sym # of pins=2
** sym_path: /home/halst/pro/aicex/ip/lelo_gr03_sky130a/design/JNW_TR_SKY130A/JNWTR_CAPX1.sym
** sch_path: /home/halst/pro/aicex/ip/lelo_gr03_sky130a/design/JNW_TR_SKY130A/JNWTR_CAPX1.sch
.subckt JNWTR_CAPX1 A B
*.iopin A
*.iopin B
XC1 B A sky130_fd_pr__cap_mim_m3_1 W=5 L=5 MF=1 m=1
.ends

.end
