analogicus/lelo_gr03_sky130a/sim/BANDGAP_OTA_AC_TB/output_tran/tran_SchGtKffThVh.yaml

dcgain_-20: 73.7486
dcgain_0: 73.2994
dcgain_100: 70.9883
dcgain_125: 70.2881
dcgain_25: 72.7532
dcgain_50: 72.2008
pmraw_-20: -137.268
pmraw_0: -138.097
pmraw_100: -141.296
pmraw_125: -141.914
pmraw_25: -139.054
pmraw_50: -139.878
ugbw_-20: 25304900.0
ugbw_0: 24176800.0
ugbw_100: 19985600.0
ugbw_125: 19138600.0
ugbw_25: 22929900.0
ugbw_50: 21850600.0
