analogicus/lelo_gr03_sky130a/sim/BANDGAP_OTA_AC_TB/output_tran/tran_SchGtKffThVl.yaml

dcgain_-20: 73.383
dcgain_0: 72.9533
dcgain_100: 70.6319
dcgain_125: 69.8937
dcgain_25: 72.424
dcgain_50: 71.876
pmraw_-20: -141.243
pmraw_0: -142.019
pmraw_100: -144.626
pmraw_125: -145.153
pmraw_25: -142.766
pmraw_50: -143.432
ugbw_-20: 21054000.0
ugbw_0: 20206400.0
ugbw_100: 17102500.0
ugbw_125: 16432700.0
ugbw_25: 19315300.0
ugbw_50: 18523400.0
