analogicus/lelo_gr03_sky130a/sim/BANDGAP_OTA_AC_TB/output_tran/tran_SchGtKfsThVh.yaml

dcgain_-20: 73.5765
dcgain_0: 73.0785
dcgain_100: 70.27
dcgain_125: 69.3484
dcgain_25: 72.4529
dcgain_50: 71.7947
pmraw_-20: -134.648
pmraw_0: -135.663
pmraw_100: -139.136
pmraw_125: -139.742
pmraw_25: -136.724
pmraw_50: -137.632
ugbw_-20: 19653100.0
ugbw_0: 18723800.0
ugbw_100: 15367400.0
ugbw_125: 14678800.0
ugbw_25: 17731800.0
ugbw_50: 16868200.0
