analogicus/lelo_gr03_sky130a/sim/BANDGAP_OTA_AC_TB/output_tran/tran_SchGtKfsThVl.yaml

dcgain_-20: 73.1079
dcgain_0: 72.6145
dcgain_100: 69.6363
dcgain_125: 68.6094
dcgain_25: 71.979
dcgain_50: 71.2913
pmraw_-20: -139.179
pmraw_0: -139.955
pmraw_100: -142.683
pmraw_125: -143.131
pmraw_25: -140.776
pmraw_50: -141.492
ugbw_-20: 16196200.0
ugbw_0: 15546500.0
ugbw_100: 13057100.0
ugbw_125: 12510000.0
ugbw_25: 14837200.0
ugbw_50: 14203400.0
