analogicus/lelo_gr03_sky130a/sim/BANDGAP_OTA_AC_TB/output_tran/tran_SchGtKsfThVh.yaml

dcgain_-20: 74.1266
dcgain_0: 73.7636
dcgain_100: 72.0133
dcgain_125: 71.4985
dcgain_25: 73.3376
dcgain_50: 72.9173
pmraw_-20: -131.405
pmraw_0: -132.393
pmraw_100: -136.182
pmraw_125: -136.998
pmraw_25: -133.464
pmraw_50: -134.427
ugbw_-20: 21559000.0
ugbw_0: 20590300.0
ugbw_100: 17124700.0
ugbw_125: 16409900.0
ugbw_25: 19566200.0
ugbw_50: 18677200.0
