analogicus/lelo_gr03_sky130a/sim/BANDGAP_OTA_AC_TB/output_tran/tran_SchGtKsfThVl.yaml

dcgain_-20: 73.889
dcgain_0: 73.5459
dcgain_100: 71.8441
dcgain_125: 71.3246
dcgain_25: 73.1423
dcgain_50: 72.7389
pmraw_-20: -135.991
pmraw_0: -136.795
pmraw_100: -140.145
pmraw_125: -140.883
pmraw_25: -137.691
pmraw_50: -138.527
ugbw_-20: 17594100.0
ugbw_0: 16988500.0
ugbw_100: 14546200.0
ugbw_125: 13999100.0
ugbw_25: 16313400.0
ugbw_50: 15697600.0
