analogicus/lelo_gr03_sky130a/sim/BANDGAP_OTA_AC_TB/output_tran/tran_SchGtKssThVh.yaml

dcgain_-20: 74.0837
dcgain_0: 73.717
dcgain_100: 71.8919
dcgain_125: 71.3355
dcgain_25: 73.2818
dcgain_50: 72.8468
pmraw_-20: -129.904
pmraw_0: -130.994
pmraw_100: -135.18
pmraw_125: -136.05
pmraw_25: -132.18
pmraw_50: -133.248
ugbw_-20: 17042600.0
ugbw_0: 16260300.0
ugbw_100: 13468200.0
ugbw_125: 12896800.0
ugbw_25: 15433000.0
ugbw_50: 14716000.0
