analogicus/lelo_gr03_sky130a/sim/BANDGAP_OTA_AC_TB/output_tran/tran_SchGtKssThVl.yaml

dcgain_-20: 73.7326
dcgain_0: 73.3973
dcgain_100: 71.632
dcgain_125: 71.0643
dcgain_25: 72.9935
dcgain_50: 72.5793
pmraw_-20: -134.948
pmraw_0: -135.815
pmraw_100: -139.421
pmraw_125: -140.225
pmraw_25: -136.79
pmraw_50: -137.702
ugbw_-20: 13862500.0
ugbw_0: 13357100.0
ugbw_100: 11390200.0
ugbw_125: 10949300.0
ugbw_25: 12803400.0
ugbw_50: 12305200.0
