analogicus/lelo_gr03_sky130a/sim/BANDGAP_OTA_AC_TB/output_tran/tran_SchGtKttTtVt.yaml

dcgain_-20: 73.786
dcgain_0: 73.3963
dcgain_100: 71.3816
dcgain_125: 70.755
dcgain_25: 72.9255
dcgain_50: 72.4474
pmraw_-20: -135.232
pmraw_0: -136.145
pmraw_100: -139.624
pmraw_125: -140.362
pmraw_25: -137.13
pmraw_50: -138.016
ugbw_-20: 18859600.0
ugbw_0: 18059800.0
ugbw_100: 15126600.0
ugbw_125: 14508500.0
ugbw_25: 17204700.0
ugbw_50: 16453800.0
