analogicus/lelo_gr03_sky130a/(commit log)

2026-01-04 Made LELO_GR03_SKY130A
    [LELO_GR03.sch]
2026-01-22 Added default sch and lay
    [LELO_GR03.sch, tt_um_lelo_gr03_analogicus.sch]
2026-02-06 Created bandgap circuit and made a testbench for the OTA
2026-02-06 Added previously not included files
    [BANDGAP_CIRCUIT.sch, BANDGAP_OTA.sch, BANDGAP_OTA_TB.sch]
2026-02-11 Added schematics
    [BANDGAP_CIRCUIT.sch, BANDGAP_OTA.sch, BANDGAP_OTA_TB.sch]
2026-02-13 OTA remake
    [BANDGAP_CIRCUIT.sch, BANDGAP_OTA.sch]
2026-02-13 Milestone 1 Bandgap circuit
    [BANDGAP_CIRCUIT.sch, BANDGAP_OTA.sch, BANDGAP_OTA_TB.sch, LELOATR_LVT_NCH_12C5F0.sch, LELOATR_LVT_NCH_2C5F0.sch, LELOATR_LVT_NCH_4C5F0.sch, LELOATR_LVT_NCH_8C5F0.sch, LELOATR_LVT_PCH_12C5F0.sch]
2026-02-13 Fix OTA and add temperature sweep simulation plots
    - Remove x9 PMOS in BANDGAP_OTA (gate tied to VSS was pulling VTAIL
    high, disabling the differential pair)
    - Swap OTA IN+/IN- in netlist to fix feedback polarity (was positive
    feedback, now correct negative feedback)
    - Add plot_temp_sweep.py for post-processing raw files
    - Add PTAT current and bandgap voltage plots to README
    - I_PTAT ~2µA at 25C (PTAT), V_CTAT ~0.70V at 25C (CTAT)
    [BANDGAP_OTA.sch]
2026-02-13 Made changes
    [BP_OTA.sch]
2026-02-13 added readme with plots and circuits
2026-02-22 Refined design
    [BANDGAP_CIRCUIT.sch, BANDGAP_OTA.sch, BANDGAP_OTA_TB.sch, BP_OTA.sch]
2026-02-25 Fixed pwrup signals
    [BANDGAP_CIRCUIT.sch, BANDGAP_CIRCUIT_TB.sch]
2026-02-25 Changed the test to not be so verbose for bandgap circuit
2026-02-25 Added oscillator and fixed everything
    [COMPARATOR.sch, OSCILLATOR.sch, OSCILLATOR_TB.sch]
2026-02-25 Added D flip flop
    [OSCILLATOR.sch, OSCILLATOR_TB.sch]
2026-02-27 Added simulation folder for the oscillator tb
    [BANDGAP_CIRCUIT.sch, BANDGAP_CIRCUIT_TB.sch, BANDGAP_OTA.sch, BANDGAP_OTA_TB.sch, BP_OTA.sch, COMPARATOR.sch, OSCILLATOR.sch, OSCILLATOR_TB.sch]
2026-02-27 updated spi and meas
2026-02-27 milestone 2 update
    [OSCILLATOR_TB.sch, OSCILLATOR_TB_xsch.sch]
2026-02-27 Added leakage current plot and corners
    [BANDGAP_CIRCUIT_TB.sch]
2026-03-06 Added schematics to info.yaml
2026-03-06 Fixed transistor library
    [BANDGAP_OTA.sch, COMPARATOR.sch]
2026-03-06 Removed wrong transistor library
    [LELOATR_LVT_NCH_12C5F0.sch, LELOATR_LVT_NCH_2C5F0.sch, LELOATR_LVT_NCH_4C5F0.sch, LELOATR_LVT_NCH_8C5F0.sch, LELOATR_LVT_PCH_12C5F0.sch, LELOATR_LVT_PCH_2C5F0.sch, LELOATR_LVT_PCH_4C5F0.sch, LELOATR_LVT_PCH_8C5F0.sch]
2026-03-06 Update README with frequency and temperature resolution details
    Clarified the resolution issue with temperature readings from the oscillator.
2026-03-06 Update README with additional details on plots
    Expanded description of PTAT and CTAT plots to include leakage current.
2026-03-06 Fix typo in README regarding leakage current
2026-03-06 Fix equation formatting in README.md
    Corrected formatting of the voltage difference equation for clarity.
2026-03-06 Fix LaTeX formatting for voltage difference equation
    Updated the LaTeX formatting for the voltage difference equation in the README.
2026-03-06 Fix equation formatting in README.md
    Corrected formatting of the equation for voltage difference between diodes.
2026-03-06 Correct LaTeX syntax in README.md
    Fix LaTeX formatting for voltage difference equation in README.
2026-03-06 Update README with additional Bandgap circuit details
    Added equation for voltage difference and defined V_T.
2026-03-06 Improve explanation of I_PTAT in README
    Clarified the explanation of I_PTAT and its relationship with the op amp and resistor R1.
2026-03-06 Increased current to increase frequency
    [BANDGAP_CIRCUIT.sch]
2026-03-06 Fix typo in README.md regarding schematic description
2026-03-06 Enhance oscillator description in README
    Updated the explanation of the oscillator circuit to include details about the D-flip-flop and clarified the role of capacitance in the frequency calculation.
2026-03-08 Optimize simulation speed/IO and improve measurement plots
    Simulation improvements:
    - Reduce .save to only needed signals (oscillator: 2, bandgap: 3)
    - Add method=gear for bandgap leakage accuracy
    - Reduce oscillator sim time from 8u to 5u
    - Eliminate redundant Th/Tl temperature corners in etc targets
    - Add active supply current (Iact) measurement for bandgap
    - Standardize temperature sweep to 18 points (-40 to 125C, 10C steps)
    Plot improvements:
    - Rewrite tran.py for both TBs: 2x2 subplot layout, consistent
    color/style per process corner, single shared legend
    - Oscillator: freq vs temp, 1-pt and 2-pt calibration error, Iact
    - Bandgap: PTAT current, CTAT voltage, leakage, Iact
    Housekeepi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
2026-03-08 Update README with current simulation results and fix formatting
    Add key parameters (frequency, leakage, active current, calibration
    accuracy), update plot descriptions to match current 2x2 subplot
    layouts, add schematic references and BJT ratio, fix typos and
    notation consistency.
2026-03-08 Add schematics section, temp error estimation, and anchor links to README
    - Add dedicated Schematics section with embedded SVG references for
    BANDGAP_OTA, BANDGAP_CIRCUIT, COMPARATOR, and OSCILLATOR
    - Add temperature error estimation subsection explaining 1-pt and 2-pt
    calibration methodology with equations
    - Replace "Schematics page" references with in-document anchor links
2026-03-13 Revise frequency equation in README for clarity
    Updated the frequency equation to include temperature dependence for I_PTAT and V_CTAT.
2026-03-13 Minor aesthetic tweak in bandgap_ota schematic
    [BANDGAP_OTA.sch]
2026-03-13 Aeasthetic tweaks
    [OSCILLATOR.sch]
2026-03-13 Reduced bias current and better power gating
    [BANDGAP_CIRCUIT.sch, BANDGAP_OTA.sch, COMPARATOR.sch, OSCILLATOR.sch]
2026-03-13 Updated design with less current
    [BANDGAP_CIRCUIT.sch, BANDGAP_CIRCUIT_TB.sch, BANDGAP_OTA.sch, OSCILLATOR.sch]
2026-03-13 Updated design, will run new tests soon
    [BANDGAP_CIRCUIT.sch]
2026-03-14 Made a digital counter (it double-counts to 2x sample rate)
    [tb_tran_SchGtKffThVh.csv, tb_tran_SchGtKffThVl.csv, tb_tran_SchGtKffTlVh.csv, tb_tran_SchGtKffTlVl.csv, tb_tran_SchGtKfsThVh.csv, tb_tran_SchGtKfsThVl.csv, tb_tran_SchGtKfsTlVh.csv, tb_tran_SchGtKfsTlVl.csv]
2026-03-19 Updated design, better stability and lower current
    [BANDGAP_CIRCUIT.sch, BANDGAP_OTA.sch, COMPARATOR.sch, OSCILLATOR.sch]
2026-03-20 Modified circuit, better performance overall
    [BANDGAP_CIRCUIT.sch, BANDGAP_OTA.sch, COMPARATOR.sch, COMPARATOR_TB.sch]
2026-03-22 Updated everything
    [BANDGAP_CIRCUIT.sch, BANDGAP_CIRCUIT_LEAK_TB.sch, BANDGAP_CIRCUIT_TB.sch, BANDGAP_OTA_LG_TB.sch, BANDGAP_OTA_PMOS.sch, BANDGAP_OTA_TB.sch, OSCILLATOR.sch, OSCILLATOR_TB_xsch.sch]
2026-03-24 Small adjustments
    [BANDGAP_CIRCUIT.sch, BANDGAP_CIRCUIT_TB.sch, BANDGAP_OTA_LG_TB.sch, BANDGAP_OTA_PMOS.sch, BIAS_CIRCUIT.sch, COMPARATOR.sch, OSCILLATOR.sch]
2026-03-24 Adjusted calibration
2026-03-24 Updated schematics
2026-03-24 Fixed small schematic error
    [OSCILLATOR.sch]
2026-03-26 Small changes
    [OSCILLATOR_TB_xsch.sch, tb_tran_SchGtKffThVh.csv, tb_tran_SchGtKffThVl.csv, tb_tran_SchGtKffTlVh.csv, tb_tran_SchGtKffTlVl.csv, tb_tran_SchGtKfsThVh.csv, tb_tran_SchGtKfsThVl.csv, tb_tran_SchGtKfsTlVh.csv]
2026-04-10 Generated digital layout and optimized power consumption
    [BANDGAP_CIRCUIT.sch, BANDGAP_CIRCUIT_LEAK_TB.sch, BANDGAP_CIRCUIT_LG_TB.sch, COMPARATOR.sch, OSCILLATOR.sch, tb_tran_SchGtKffThVh.csv, tb_tran_SchGtKffThVl.csv, tb_tran_SchGtKffTlVh.csv]
2026-04-13 Started with layout of bias circuit (planning to look at automated/agent-driven layout generation))
    [BIAS_CIRCUIT.sch]
2026-04-13 Major update
    [BANDGAP_CIRCUIT.sch, BANDGAP_OTA_PMOS.sch, COMPARATOR.sch, OSCILLATOR.sch, pin_order.cfg, tb_tran_SchGtKffThVh.csv, tb_tran_SchGtKffThVl.csv, tb_tran_SchGtKffTlVh.csv]
2026-04-13 Add VDD/VSS power rings and connections to BIAS_CIRCUIT
2026-04-13 Route net1 from res chain to pmos PWRUP in BIAS_CIRCUIT
2026-04-13 WIP snapshot: drop fillDummyTransistors, filter power, add intra-stack routes
    - afterPlace: remove pmos.fillDummyTransistors + routeDummyDevices — cicpy's
    helper was creating a 1394-rect M1 short merging PWRUP_1V8/VB_N/VB_P/VSS
    and several internal nets.
    - afterPlace: move res to abutRight of pmos temporarily to work around the
    resistor M1 bulk frame spanning the cell width. (Will revert to abutTop in
    the next commit — requirement is resistors above/below, not beside.)
    - beforeRoute: addPowerConnection now filters ^x[bc]\d+$ so resistor bulk
    frames are not stretched into the VDD/VSS rings.
    - beforeRoute: add intra-stack routes for net2/net3 (nmos) and net4 (pmos)
    at track4; n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
2026-04-13 Task 13 milestone: shorts=0, 4 opens remain
    Major fixes:
    - Remove VDD in-cell strap entirely (was root cause of cell-spanning
    M1 sheet short). VDD is left for parent cell to route via the top
    ring port. Accepted as open in connectivity check.
    - Route net5/net6 (resistor intra-stack nets) via addOrthogonal on
    M2/M3 with accessLayer=M1 since resistors expose M1 terminals.
    - VB_N right-edge port temporarily disabled pending diode access fix.
    Remaining opens: VDD (parent), VSS (resistor taps), VB_N (diode
    M1 drain not in M2 access route), VB_P (same).
2026-04-13 Task 13: shorts=0, VB_N port back, net6 uses local M2 strap
2026-04-14 Task 13 WIP: restore VDD addPowerConnection to let Magic/LVS extract
    The cicpy connectivity check flags VDD-vs-VSS geometric overlap as a
    short (M1 straps from pmos sources cross res's M1 bulk-frame VSS
    rectangles on the way up to the top VDD ring). However, Berkeley
    netgen LVS (just built from RTimothyEdwards/netgen source and
    installed to ~/.local/bin) shows that VSS extracts correctly even
    though cicpy reports it as split — the Magic extractor handles the
    power rails through label propagation. Testing whether VDD does the
    same.
2026-04-14 Revert VDD strap and res intra-stack routes; defer to klayout post-process
2026-04-14 Task 13 handoff: defer VDD/diode/resistor-net fixes to klayout post-process
    Adds docs/plans/2026-04-14-bias-circuit-task-13-handoff.md — a
    comprehensive resumption note documenting:
    - Current state (HEAD 49b61d9: cicpy shorts=0 but 6 opens)
    - Why each open exists (VDD strap crosses res locali; diode gate/drain
    split across layers; resistor terminals only on li1; stray VB_N port
    label in res y-range)
    - The klayout post-processing plan with concrete coordinates, layer
    numbers, and priority-ordered repairs
    - Tooling set up this session (Berkeley netgen 1.5.318 built from
    source at ~/.local/bin, klayout 0.30.7 pya verified working)
    - sky130 GDS layer map and cell-relative port coordin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
2026-04-14 Layout for OTA almost done
    [BANDGAP_OTA_PMOS.sch]
2026-04-16 Layout for OTA done
    [BANDGAP_CIRCUIT.sch, BANDGAP_OTA_PMOS.sch, PMOS.sch, tb_tran_SchGtKffThVh.csv, tb_tran_SchGtKffThVl.csv, tb_tran_SchGtKfsThVh.csv, tb_tran_SchGtKfsThVl.csv, tb_tran_SchGtKsfThVh.csv]
2026-04-16 Minor digital temperature offset fix
    [tb_tran_SchGtKffThVh.csv, tb_tran_SchGtKffThVl.csv, tb_tran_SchGtKffTlVh.csv, tb_tran_SchGtKfsThVh.csv, tb_tran_SchGtKfsThVl.csv, tb_tran_SchGtKsfThVh.csv, tb_tran_SchGtKsfThVl.csv, tb_tran_SchGtKssThVh.csv]
2026-04-17 Did small adjustments to bias circuit layout
2026-04-17 Comparator layout done and passed lvs/drc
    [BANDGAP_CIRCUIT.sch, COMPARATOR.sch]
2026-04-17 Made inital draft of circuit, now it needs to fix its 27 drc errors
2026-04-17 wired together bias circuit, with drc and lvs passing
    [BIAS_CIRCUIT.sch]
2026-04-17 Add design doc for temp_sens digital layout shrink
    Plan to reduce temp_sens layout from 4436 um^2 via config knobs
    (CLOCK_PERIOD 10000ns, FP_CORE_UTIL 65, _1 drive cells), add SDC
    coverage for the i_clk_osc dual-edge counter domain, and move the
    oscillator feedback pins to the south edge to match the top-level
    floorplan. Verification path runs LibreLane locally via Nix and
    checks GLS+SDF calibration error per corner is no worse than RTL.
2026-04-17 Add compare_calibration.py: peak 1pt/2pt calibration error extractor
    [compare_calibration.py]
2026-04-17 Move oscillator feedback pins to south edge (abut COMPARATOR/BIAS)
    [pin_order.cfg]
2026-04-17 Switch synth.yaml to Nix + fossi-foundation binary cache
2026-04-17 added new measurements
    [tb_tran_SchGtKffThVh.csv, tb_tran_SchGtKffThVl.csv, tb_tran_SchGtKffTlVh.csv, tb_tran_SchGtKffTlVl.csv, tb_tran_SchGtKfsThVh.csv, tb_tran_SchGtKfsThVl.csv, tb_tran_SchGtKfsTlVh.csv, tb_tran_SchGtKfsTlVl.csv]
2026-04-18 LELO_GR03 Layout almost done
    [BIAS_CIRCUIT2.sch, LELO_GR03.sch]
2026-04-18 img update
    [tb_tran_SchGtKffThVh.csv, tb_tran_SchGtKffThVl.csv, tb_tran_SchGtKffTlVh.csv, tb_tran_SchGtKfsThVh.csv, tb_tran_SchGtKfsThVl.csv, tb_tran_SchGtKsfThVh.csv, tb_tran_SchGtKsfThVl.csv, tb_tran_SchGtKssThVh.csv]
2026-04-24 Embed LELO_ATR_SKY130A cells directly; remove lelo_atr_sky130a dependency
    Replace design/LELO_ATR_SKY130A symlink (→ wulffern/lelo_atr_sky130a) with a
    real directory containing the two cells used by this design. The GitHub version
    of LELOATR_LVT_PCH_4C5F0.mag was missing nwell and pmoslvt layers, causing
    Magic to generate a broken SPICE that segfaulted netgen in CI.
    Remove lelo_atr_sky130a from config.yaml since cells are now self-contained.
    [LELOATR_LVT_NCH_4C5F0.sch, LELOATR_LVT_PCH_4C5F0.sch]
2026-04-24 Sure hope this works
    [BANDGAP_OTA_PMOS.sch]
2026-04-24 Override xlvs to strip rf_pnp BJT wrapper before netgen
    The upstream tech_sky130A/make/core.make is missing a perl step that removes
    the sky130_fd_pr__rf_pnp_05v5_W* subcircuit wrapper Magic generates in the SPI.
    That wrapper contains a **devattr line that causes netgen to segfault. Local
    core.make has this step; CI uses the GitHub version which doesn't, hence the crash.
2026-04-24 lpe: print full LVS log and x10 nets for CI debug
    CI uses Magic rev 541 vs local rev 589; hard-coded node-name perl
    fixes may not match. Print the netgen log and DFF net list so the
    CI output reveals exactly what is mismatching.
2026-04-25 Fix body-float in JNWTR_PCHDL/NCHDL for Magic rev 541
    Magic rev 541 (CI Docker) does not automatically connect the nwell/pwell
    body contacts to the supply rail through abutment, so PFET bodies in
    IVX1_CV, NDX1_CV, IVTRIX1_CV, NDTRIX1_CV end up floating (net MP0/B or
    net 0 instead of AVDD/AVSS), causing LPE LVS failure.
    Fix: embed patched copies in LELO_GR03_SKY130A/ (first in Magic search
    path) that add a locali strap from the B ntap to the S diffusion contact,
    making body=source explicit at the primitive cell level regardless of
    Magic version.
    JNWTR_PCHDL: adds rect 90 25 540 55 (connects S at x=90-180 to B ntap
    at x=450-540 across y=25-55, between the two poly gates)
    JNWTR_NCHDL: adds r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
2026-04-25 fix: put LELO_GR03_SKY130A first in Magic addpath so PCHDL/NCHDL patches take effect
    Magic's addpath prepends to the search list, so the last-added directory is
    searched first. Previously JNW_TR_SKY130A was last (= highest priority) and
    our patched JNWTR_PCHDL/JNWTR_NCHDL in LELO_GR03_SKY130A were never loaded.
    Reorder so LELO_GR03_SKY130A is last (= first searched), allowing the locali
    straps that tie PFET body to source and NFET body to source to take effect.
    Also add PFET body connection debug output to Makefile lpe target for CI.
2026-04-26 fix: add locali body-tie straps in gate cell copies to fix Magic rev 541 LVS
    In Magic rev 541 (CI), hierarchical extraction does not connect PFET/NFET
    body terminals to AVDD/AVSS via nwell/pwell continuity across cell boundaries.
    The JNWTR_PCHDL locali strap (connecting B to S within the primitive) does not
    work in rev 541 hierarchical mode.
    Fix by patching the four affected parent cells at the LELO_GR03_SKY130A level:
    - JNWTR_IVX1_CV: rect 585 25 1035 55 (PCHDL.B→AVDD); rect -45 25 405 55 (NCHDL.B→AVSS)
    - JNWTR_NDX1_CV: same + rect 945 25 1035 140 / rect -45 25 45 140 to reach MP1/MN1 bodies
    - JNWTR_IVTRIX1_CV: same as NDX1_CV (identical cell structure)
    - JNWTR_NDTRIX1_CV: rect 585 105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
2026-04-30 Added benchmark for bandgap ota and comparator
    [gls_tran_SchGtKttTtVt.csv, temp_sweep.csv]
2026-04-30 temp_sens: clean up RTL/SDC and port digital flow to OpenLane 2
    - Add missing o_valid output port (was driven internally but undeclared)
    - Remove unused count_reg; refactor count to 8-bit (carry was always discarded)
    - SDC: exclude i_clk/i_clk_osc from set_input_delay (kills 22 STA-0441 warnings)
    - pin_order.cfg: add o_valid on north edge
    - config.json: port to OpenLane 2 schema; tune for area (FP_CORE_UTIL=70, AREA 0)
    - Delete temp_sens2.sv (abandoned rewrite, module name didn't match DESIGN_NAME)
    Sim verified bit-identical -40C..+125C; layout signoff clean (DRC/LVS/Antenna),
    0 Verilator lint, core area -9% vs prior config.
    [pin_order.cfg]
2026-04-30 Regenerate temp_sens.mag via OpenLane 2 (3833 um^2, was 4006 um^2)
    Tighten area config: FP_CORE_UTIL=80, SYNTH_STRATEGY="AREA 0", and
    disable port-buffer repair passes (DESIGN_REPAIR_BUFFER_INPUT/OUTPUT_PORTS).
    Setup slack +496 ns, hold slack +0.16 ns. DRC/LVS/Antenna clean.
2026-04-30 README figures: switch from PNG to vector SVG/PDF
    - work/Makefile: drop PNG generation; readme-figures now produces
    ../svgs/LELO_GR03.{svg,pdf} and ../svgs/physical_design.{svg,pdf}
    via Magic plot svg + rsvg-convert.
    - README: update layout image refs from .png to .svg.
    - Regenerate the two layout figures from the current .mag files.
    - Remove orphan svgs/LELO_GR03.png and svgs/physical_design.png.
2026-04-30 sim: emit_latex_params helpers in each tran.py
    Each post-process script writes a sim_params.tex next to its yaml
    outputs; an external LaTeX report can \InputIfFileExists these to keep
    the hand-written numbers in sync with the simulation. BANDGAP_CIRCUIT_TB
    emits the PTAT-current corner spread (26%); OSCILLATOR_TB emits the
    worst-case per-corner 1st/2nd-order polyfit residuals (8.7°C / 2.1°C),
    which match the K_err table rows. The remaining tran.py files have a
    no-op skeleton ready to populate.
    .gitignore: allow !**/output_*/sim_params.tex through the output_*
    exclusion so the auto-generated values can be committed.
2026-04-30 OSCILLATOR_TB: spec-correct 1-pt and 2-pt cal residuals
    Rewrite emit_latex_params to use the project spec's calibration
    definitions (l01_project.pdf §A): one production measurement at 25°C
    plus a fixed nominal slope (1-pt), or two measurements at 25°C and
    85°C with a line through both (2-pt). Worst |error| is taken across
    non-MC PVT corners restricted to the spec's 0–70°C accuracy range.
    Previously the helper computed per-corner polyfit residuals over
    the full -40..125°C range, which is a different metric (a theoretical
    linearity bound, not a calibration error). The chip really delivers
    \valKerrone = 10.7°C (1-pt, marginally over the ±10°C spec at extreme
    corners KssVl/KffVh) and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
2026-04-30 Switch SVG->PDF to chromium; expand LELO_GR03 inside physical_design
    rsvg-convert can't render Magic's <pattern>+<filter> layer fills
    (produces nearly-blank output). Chromium has full SVG support.
    - work/svg2pdf.sh: new helper that wraps SVG in HTML with @page CSS
    matching the SVG dimensions and runs `chromium --headless --print-to-pdf`.
    Fixes pipefail SIGPIPE bug in width/height extraction by using grep -m1.
    - work/Makefile: pdf rules now call svg2pdf.sh instead of rsvg-convert.
    - physical_design recipe: select+expand LELO_GR03_1 then unexpand its
    internal temp_sens_0 ("hide tiny details" — keeps digital sea-of-cells
    collapsed but shows analog block layout).
    - Regenerate both com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
    [tran_SchGtKttTtVt.yaml]
2026-04-30 Cleaned up and fixed layout pdf/svg
    [tb.py]
2026-04-30 LELO_GR03 figure: switch from SVG/PDF to PNG via Magic plot pnm + PIL
2026-07-21 Fixed PNPs
    [LELOATR_LVT_NCH_4C5F0.sch, LELOATR_LVT_PCH_4C5F0.sch]
2026-07-21 Fixed top level
    [tt_um_lelo_gr03_analogicus.sch]
